indrora/ecksdee-wifi-card/ecksdee-wifi-card-rounded.kicad_pcb

## KiCad design ecksdee-wifi-card-rounded.kicad_pcb (2023-01-10)

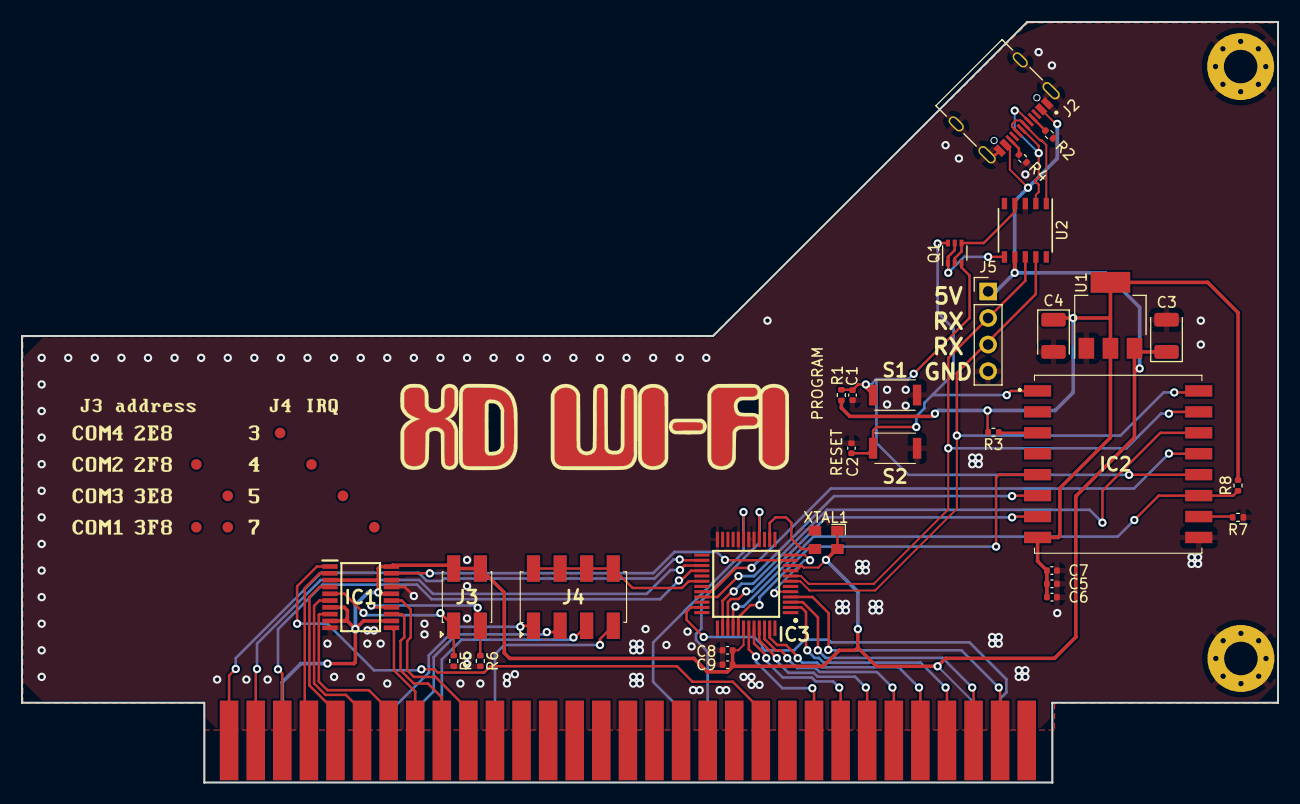
[picture p1: board ecksdee-wifi-card-rounded.kicad_pcb from above]

Board: 2 copper layers, 120.0 x 72.7 mm, 36 parts (1 on the bottom side), 53 nets.

Parts:
C1, C2, C6, C7, C8: 0.1uF; C_0402_1005Metric
C3: 10uF; CP_EIA-3528-15_AVX-H
C4: 22uF; CP_EIA-3528-15_AVX-H
C5, C9: 1uF; C_0402_1005Metric
H1, H2: MountingHole_Pad; MountingHole_3.2mm_M3_Pad_Via
IC1: SN74HC688PWR; SOP65P640X120-20N
IC2: ESP-07S; ESP07S
IC3: TL16C550CPTR; QFP50P900X900X160-48N
J1: Bus_ISA_8bit; Conn_Edge_PCB_ISA8
J2: TYPE-C-31-M-12; HRO_TYPE-C-31-M-12
J3: 95278-101A04LF; 95278101A04LF
J4: 95278-801A08LF; 95278801A08LF
J5: Conn_01x04; PinHeader_1x04_P2.54mm_Vertical
Q1: UMH3N; SOT-363_SC-70-6
R1, R2, R3, R4, R5, R6, R7, R8: 5.1K; R_0402_1005Metric
Ref**: Val**; logo
Ref**#2: Val**; addr-irq
Ref**#3: Val**; back
S1, S2: SKRKAEE020
U1: AMS1117-3.3; SOT-223-3_TabPin2
U2: CH340K; SSOP-10_3.9x4.9mm_P1.00mm
XTAL1: S3D1.843200B20F30T; SMD3225-4P

Connections:
+3V3: C4.1, C5.1, C6.1, C7.1, IC2.8 (VCC), R1.2, R3.2, R8.2, U1.2 (VO)
/ESP_GPIO0: C1.1, IC2.12 (GPIO0), Q1.3 (C2), R1.1, S1.2
/ESP_GPIO2: IC2.11 (GPIO2), IC3.40 (~DCD), R8.1
/ESP_GPIO4: IC2.13 (GPIO4), IC3.32 (~RTS)
/ESP_GPIO5: IC2.14 (GPIO5), IC3.38 (~CTS)
/ESP_GPIO12: IC2.6 (GPIO12), IC3.33 (~DTR)
/ESP_GPIO13: IC2.7 (GPIO13), IC3.39 (~DSR)
/ESP_GPIO14: IC2.5 (GPIO14), IC3.41 (~RI)
/ESP_GPIO15: IC2.10 (GPIO15), R7.2
/ESP_RST: C2.1, IC2.1 (RST), Q1.6 (C1), S2.2
/ISA_ADDR0: IC3.28 (A0), J1.60 (BA02)
/ISA_ADDR1: IC3.27 (A1), J1.61 (BA01)
/ISA_ADDR2: IC3.26 (A2), J1.62 (BA00)
/ISA_ADDR3: IC1.2 (P0), J1.59 (BA03)
/ISA_ADDR4: IC1.4 (P1), J1.58 (BA04)
/ISA_ADDR5: IC1.6 (P2), J1.57 (BA05)
/ISA_ADDR6: IC1.8 (P3), J1.56 (BA06)
/ISA_ADDR7: IC1.11 (P4), J1.55 (BA07)
/ISA_ADDR8: IC1.13 (P5), J1.54 (BA08)
/ISA_ADDR9: IC1.15 (P6), J1.53 (BA09)
/ISA_D0: IC3.43 (D0), J1.40 (DB0)
/ISA_D1: IC3.44 (D1), J1.39 (DB1)
/ISA_D2: IC3.45 (D2), J1.38 (DB2)
/ISA_D3: IC3.46 (D3), J1.37 (DB3)
/ISA_D4: IC3.47 (D4), J1.36 (DB4)
/ISA_D5: IC3.2 (D5), J1.35 (DB5)
/ISA_D6: IC3.3 (D6), J1.34 (DB6)
/ISA_D7: IC3.4 (D7), J1.33 (DB7)
/ISA_ENABLE: IC1.1 (~OE), J1.42 (AEN)
/ISA_IOR: IC3.19 (~RD1), J1.14 (~IOR)
/ISA_IOW: IC3.16 (~WR1), J1.13 (~IOW)
/ISA_IRQ3: J1.25 (IRQ3), J4.1
/ISA_IRQ4: J1.24 (IRQ4), J4.3
/ISA_IRQ5: J1.23 (IRQ5), J4.5
/ISA_IRQ7: J1.21 (IRQ7), J4.7
/ISA_RESET: IC3.35 (MR), J1.2 (RESET)
/UART_CLOCK: IC3.14 (XIN), XTAL1.3 (OUT)
/UART_IRQ: IC3.30 (INTRPT), J4.2, J4.4, J4.6, J4.8
/UART_RX: IC2.16 (TXD0), IC3.7 (SIN), J5.3, U2.9 (RXD)
/UART_SEL4: IC1.5 (Q1), J3.1, R5.1
/UART_SEL8: IC1.14 (Q5), J3.3, R6.1
/UART_TX: IC2.15 (RXD0), IC3.8 (SOUT), J5.2, U2.8 (TXD)
/USB_D+: J2.A6 (DP1), J2.B6 (DP2), U2.1 (UD+)
/USB_D-: J2.A7 (DN1), J2.B7 (DN2), U2.2 (UD-)
/USB_DTR: Q1.2 (B1), Q1.4 (E2), U2.4 (~DTR)
/USB_RTS: Q1.1 (E1), Q1.5 (B2), U2.6 (~RTS)
/~UART_SEL: IC1.19 (~P=Q), IC3.11 (~CS2)
GND: C1.2, C2.2, C3.2, C4.2, C5.2, C6.2, C7.2, C8.2, C9.2, H1.1, H2.1, IC1.10 (GND), IC1.17 (P7), IC1.18 (Q7), IC2.9 (GND), IC3.17 (WR2), IC3.18 (VSS), IC3.20 (RD2), IC3.24 (~ADS), J1.1 (GND), J1.10 (GND), J1.31 (GND), J2.A1/B12 (GND), J2.B1/A12 (GND), J2.S1 (SHIELD), J2.S2 (SHIELD), J2.S3 (SHIELD), J2.S4 (SHIELD), J5.4, R2.1, R4.1, R5.2, R6.2, R7.1, S1.1, S2.1, U1.1 (GND), U2.3 (GND), XTAL1.2 (GND)
unnamed: IC2.3 (EN), R3.1
unnamed: IC3.5 (RCLK), IC3.12 (~BAUDOUT)
unnamed: J2.A5 (CC1), R2.2
unnamed: J2.B5 (CC2), R4.2
VCC: C3.1, C8.1, C9.1, IC1.3 (Q0), IC1.7 (Q2), IC1.9 (Q3), IC1.12 (Q4), IC1.16 (Q6), IC1.20 (VCC), IC3.9 (CS0), IC3.10 (CS1), IC3.42 (VCC), J1.3 (VCC), J1.29 (VCC), J2.A4/B9 (VBUS), J2.B4/A9 (VBUS), J3.2, J3.4, J5.1, U1.3 (VI), U2.7 (VCC), XTAL1.1 (EN), XTAL1.4 (VIN)
